janelia-modular-devices/modular_device_base/README.org

#+TITLE: modular_device_base
#+AUTHOR: Peter Polidoro
#+EMAIL: peter@polidoro.io

* Repository Information
  - Author :: Peter Polidoro
  - License :: BSD
