janelia-modular-devices/modular_device_base/(list of files, drawings)

Other design files:
hardware/modular_device_teensy.dsn
pcb/modular_device_teensy.dsn
