janelia-modular-devices/modular_device_base/hardware/modular_device_teensy.kicad_pcb

## KiCad design hardware/modular_device_teensy.kicad_pcb (2016-08-08, last stored version)

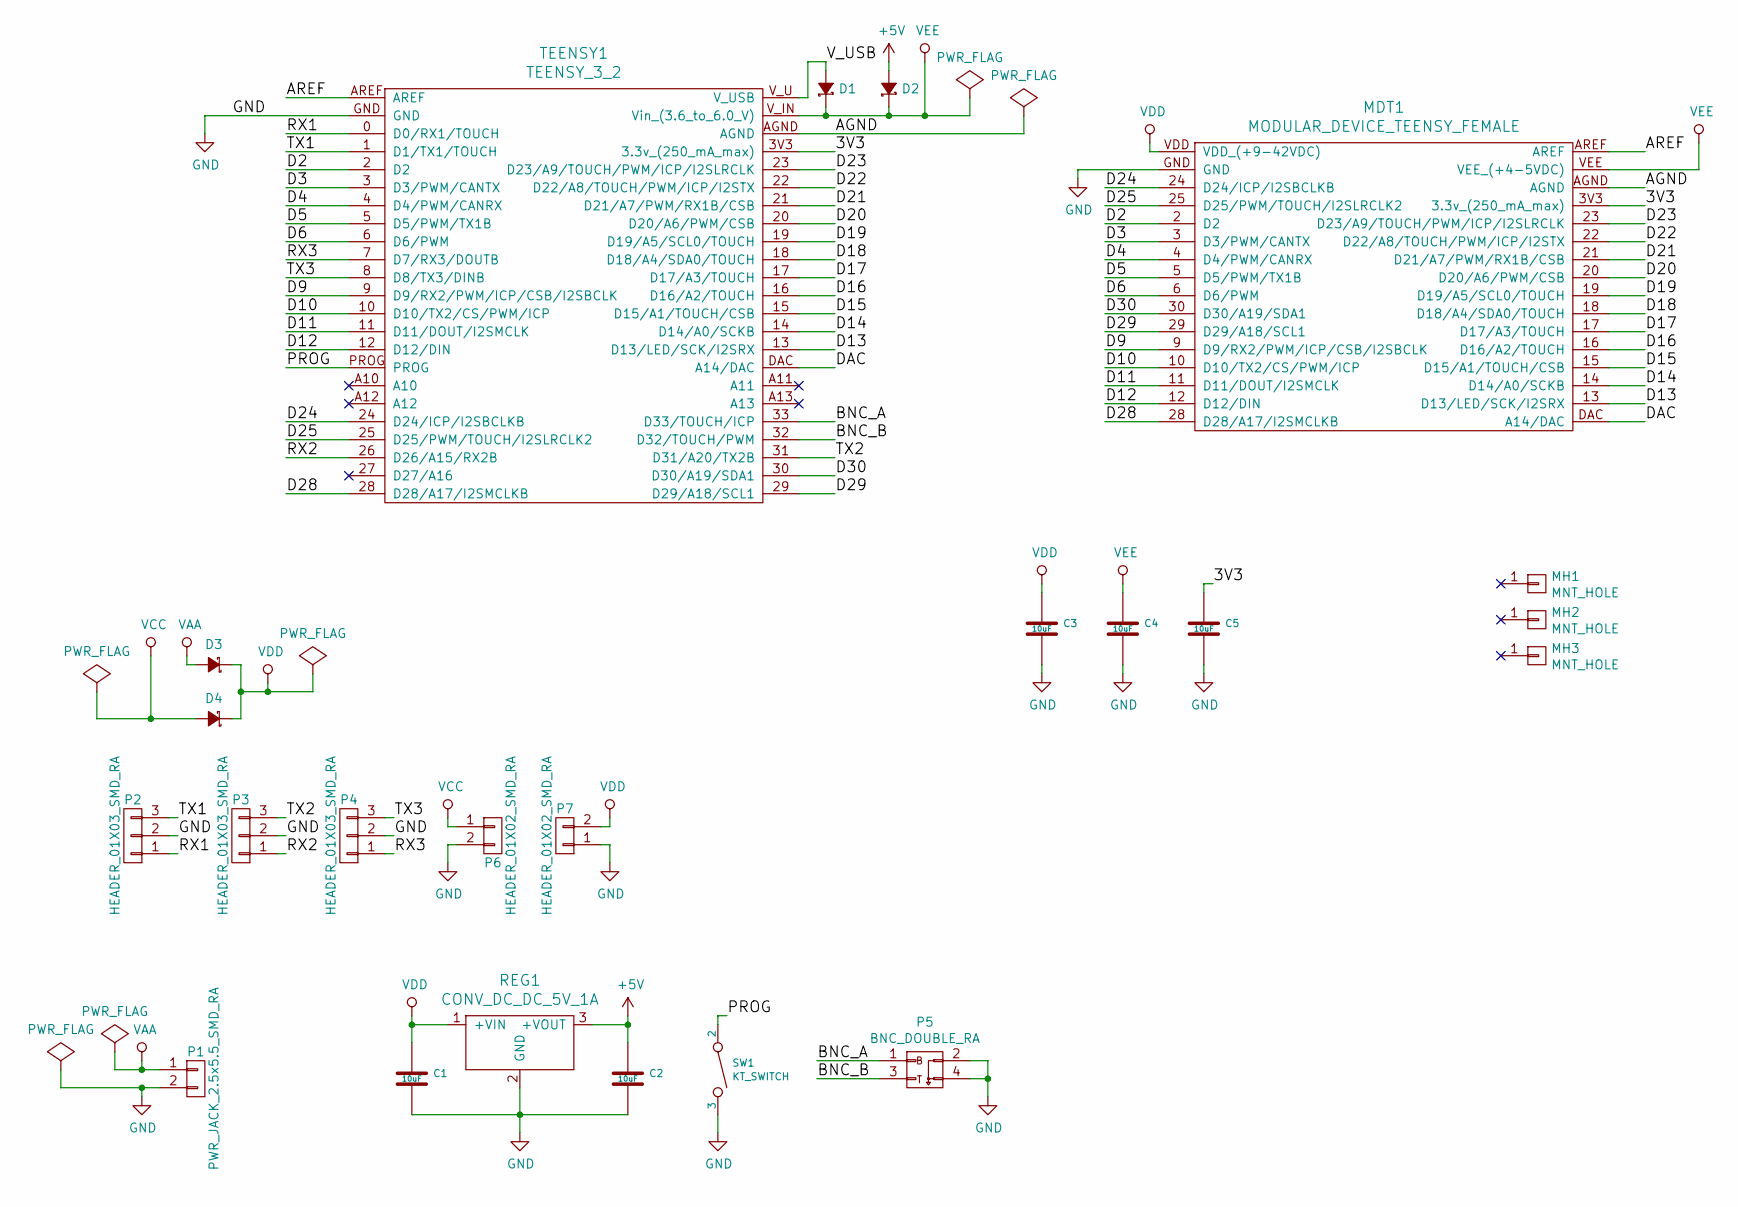
[picture p1: schematic modular_device_teensy.sch]

Parts:
C1, C2, C3, C4, C5: 10uF; SM1210; PartNumber 445-4536-1-ND
D1, D2: diode_schottky_15V_1A; DO-214BA; PartNumber LSM115JE3/TR13CT-ND
D3, D4: diode_schottky_45V_10A; CFP15; PartNumber 568-11697-1-ND
MDT1: MODULAR_DEVICE_TEENSY_FEMALE; PartNumber S7049-ND
MH1, MH2, MH3: MNT_HOLE; MOUNTING_HOLE_4-40; PartNumber 36-2027-ND
P1: PWR_JACK_2.5x5.5_SMD_RA; DCJACK_2PIN_HIGHCURRENT_SMD_RA; PartNumber CP-002BHPJCT-ND
P2, P3, P4: HEADER_01X03_SMD_RA; Header_3_Pin_SMD_RA; PartNumber A100890CT-ND
P5: BNC_DOUBLE_RA; BNC_DOUBLE; PartNumber ACX1655-ND
P6, P7: HEADER_01X02_SMD_RA; Header_2_Pin_SMD_RA; PartNumber A100903CT-ND
REG1: CONV_DC_DC_5V_1A; DC_DC_CONV_R78C; PartNumber 945-1395-5-ND
SW1: KT_SWITCH; PartNumber CKN1860CT-ND
TEENSY1: TEENSY_3_2; TEENSY_3; PartNumber 1568-1231-ND

Connections:
+5V: C2.1, D2.2 (A), REG1.3 (+VOUT)
/3V3: C5.1, MDT1.3V3 (3.3v_(250_mA_max)), TEENSY1.3V3 (3.3v_(250_mA_max))
/AGND: MDT1.AGND, TEENSY1.AGND
/AREF: MDT1.AREF, TEENSY1.AREF
/BNC_A: P5.1, TEENSY1.33 (D33/TOUCH/ICP)
/BNC_B: P5.3, TEENSY1.32 (D32/TOUCH/PWM)
/D2: MDT1.2 (D2), TEENSY1.2 (D2)
/D3: MDT1.3 (D3/PWM/CANTX), TEENSY1.3 (D3/PWM/CANTX)
/D4: MDT1.4 (D4/PWM/CANRX), TEENSY1.4 (D4/PWM/CANRX)
/D5: MDT1.5 (D5/PWM/TX1B), TEENSY1.5 (D5/PWM/TX1B)
/D6: MDT1.6 (D6/PWM), TEENSY1.6 (D6/PWM)
/D9: MDT1.9 (D9/RX2/PWM/ICP/CSB/I2SBCLK), TEENSY1.9 (D9/RX2/PWM/ICP/CSB/I2SBCLK)
/D10: MDT1.10 (D10/TX2/CS/PWM/ICP), TEENSY1.10 (D10/TX2/CS/PWM/ICP)
/D11: MDT1.11 (D11/DOUT/I2SMCLK), TEENSY1.11 (D11/DOUT/I2SMCLK)
/D12: MDT1.12 (D12/DIN), TEENSY1.12 (D12/DIN)
/D13: MDT1.13 (D13/LED/SCK/I2SRX), TEENSY1.13 (D13/LED/SCK/I2SRX)
/D14: MDT1.14 (D14/A0/SCKB), TEENSY1.14 (D14/A0/SCKB)
/D15: MDT1.15 (D15/A1/TOUCH/CSB), TEENSY1.15 (D15/A1/TOUCH/CSB)
/D16: MDT1.16 (D16/A2/TOUCH), TEENSY1.16 (D16/A2/TOUCH)
/D17: MDT1.17 (D17/A3/TOUCH), TEENSY1.17 (D17/A3/TOUCH)
/D18: MDT1.18 (D18/A4/SDA0/TOUCH), TEENSY1.18 (D18/A4/SDA0/TOUCH)
/D19: MDT1.19 (D19/A5/SCL0/TOUCH), TEENSY1.19 (D19/A5/SCL0/TOUCH)
/D20: MDT1.20 (D20/A6/PWM/CSB), TEENSY1.20 (D20/A6/PWM/CSB)
/D21: MDT1.21 (D21/A7/PWM/RX1B/CSB), TEENSY1.21 (D21/A7/PWM/RX1B/CSB)
/D22: MDT1.22 (D22/A8/TOUCH/PWM/ICP/I2STX), TEENSY1.22 (D22/A8/TOUCH/PWM/ICP/I2STX)
/D23: MDT1.23 (D23/A9/TOUCH/PWM/ICP/I2SLRCLK), TEENSY1.23 (D23/A9/TOUCH/PWM/ICP/I2SLRCLK)
/D24: MDT1.24 (D24/ICP/I2SBCLKB), TEENSY1.24 (D24/ICP/I2SBCLKB)
/D25: MDT1.25 (D25/PWM/TOUCH/I2SLRCLK2), TEENSY1.25 (D25/PWM/TOUCH/I2SLRCLK2)
/D28: MDT1.28 (D28/A17/I2SMCLKB), TEENSY1.28 (D28/A17/I2SMCLKB)
/D29: MDT1.29 (D29/A18/SCL1), TEENSY1.29 (D29/A18/SCL1)
/D30: MDT1.30 (D30/A19/SDA1), TEENSY1.30 (D30/A19/SDA1)
/DAC: MDT1.DAC (A14/DAC), TEENSY1.DAC (A14/DAC)
/PROG: SW1.2, TEENSY1.PROG
/RX1: P2.1, TEENSY1.0 (D0/RX1/TOUCH)
/RX2: P3.1, TEENSY1.26 (D26/A15/RX2B)
/RX3: P4.1, TEENSY1.7 (D7/RX3/DOUTB)
/TX1: P2.3, TEENSY1.1 (D1/TX1/TOUCH)
/TX2: P3.3, TEENSY1.31 (D31/A20/TX2B)
/TX3: P4.3, TEENSY1.8 (D8/TX3/DINB)
/V_USB: D1.2 (A), TEENSY1.V_U (V_USB)
GND: C1.2, C2.2, C3.2, C4.2, C5.2, MDT1.GND, P1.2, P2.2, P3.2, P4.2, P5.2, P5.4, P6.2, P7.1, REG1.2 (GND), SW1.3, TEENSY1.GND
VAA: D3.2 (A), P1.1
VCC: D4.2 (A), P6.1
VDD: C1.1, C3.1, D3.1 (K), D4.1 (K), MDT1.VDD (VDD_(+9-42VDC)), P7.2, REG1.1 (+VIN)
VEE: C4.1, D1.1 (K), D2.1 (K), MDT1.VEE (VEE_(+4-5VDC)), TEENSY1.V_IN (Vin_(3.6_to_6.0_V))

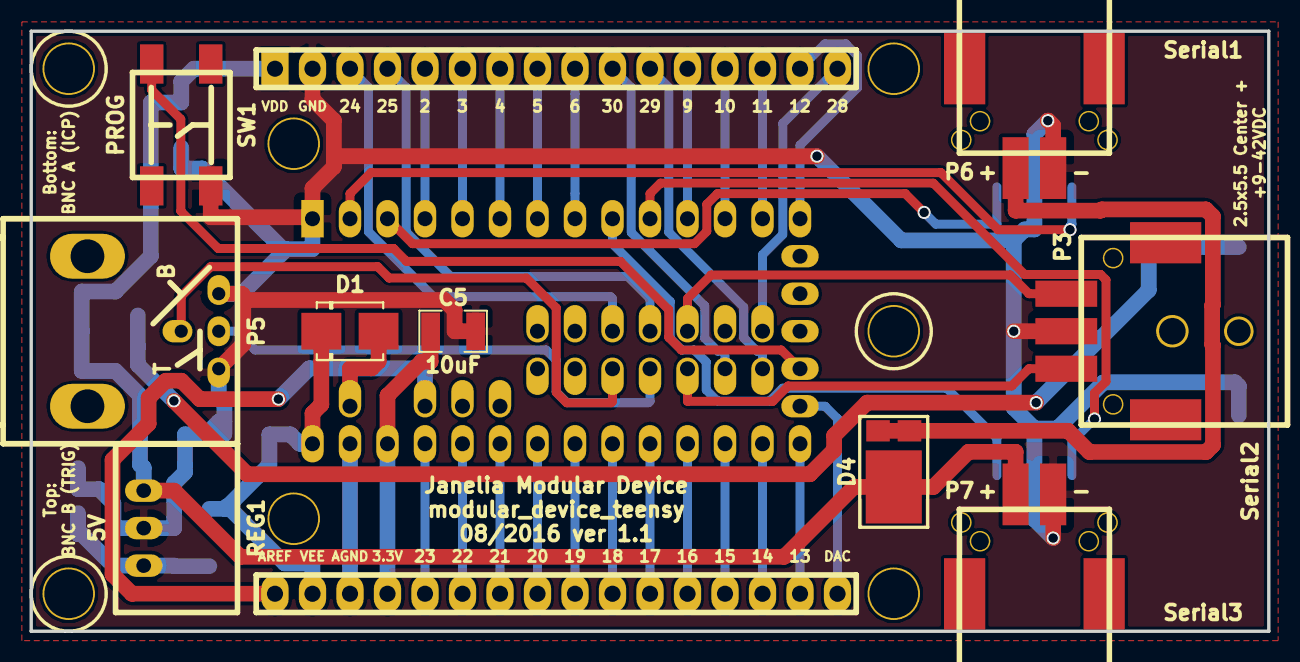
[picture p2: board modular_device_teensy.kicad_pcb from above]

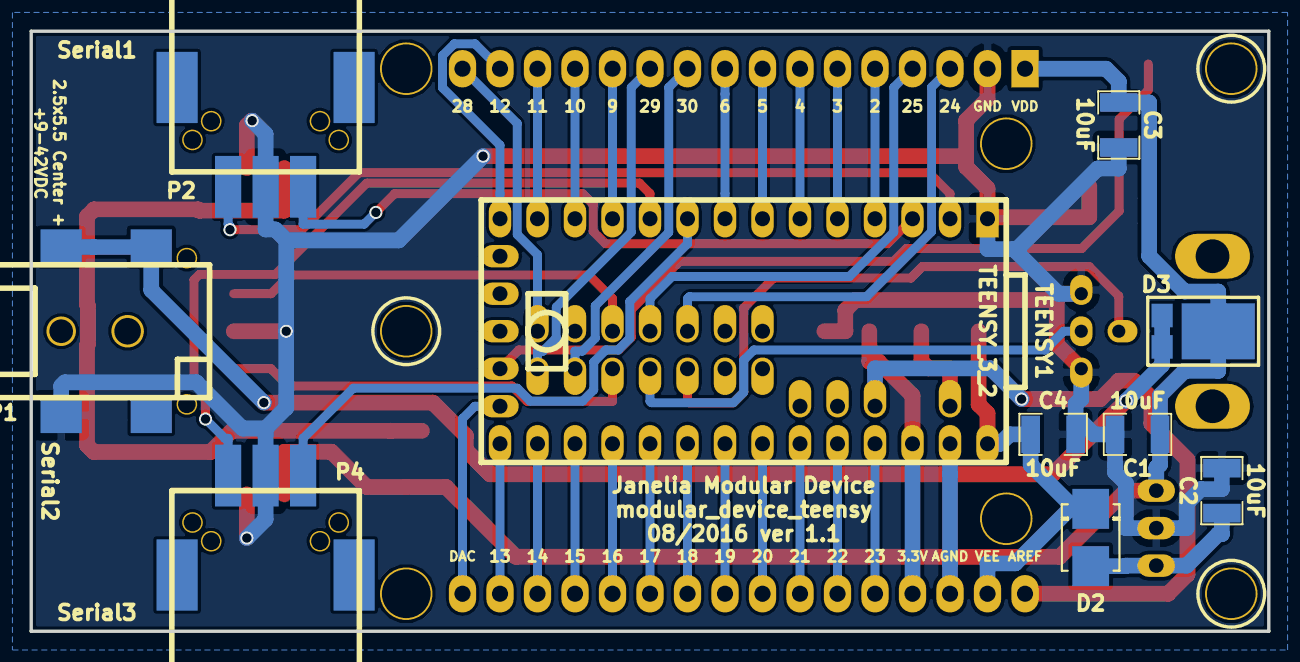
[picture p3: board modular_device_teensy.kicad_pcb from below]

Board: 2 copper layers, 83.8 x 40.6 mm, 23 parts (10 on the bottom side), 45 nets.
