janelia-modular-devices/modular_device_base/(commit log)

2016-06-03 Initial commit.
    [modular_device_teensy.kicad_pcb, modular_device_teensy.sch]
2016-06-03 Progress towards v1.0.
    [modular_device_teensy.kicad_pcb, modular_device_teensy.sch]
2016-06-17 Added some components.
    [modular_device_teensy.kicad_pcb, modular_device_teensy.sch]
2016-06-17 Progress towards board layout.
    [modular_device_teensy.kicad_pcb, modular_device_teensy.sch]
2016-06-24 More progress towards v1.0.
    [modular_device_teensy.kicad_pcb, modular_device_teensy.sch]
2016-06-28 Progess towards new layout.
    [modular_device_teensy.kicad_pcb, modular_device_teensy.sch]
2016-07-14 Small footprint placement changes.
    [modular_device_teensy.kicad_pcb]
2016-07-18 Updated component.
    [bom_pcb_add.csv, digikey_order.csv, modular_device_teensy.sch]
2016-07-18 Finished pcb v1.0.
    [bom_pcb.csv, bom_pcb_add.csv, digikey_order.csv, digikey_order_pcb.csv, digikey_order_pcb_add.csv, modular_device_teensy.sch]
2016-07-19 Updated footprint after testing.
2016-07-20 Progress towards v1.1.
    [bom_pcb_add.csv, digikey_order.csv, digikey_order_pcb_add.csv, modular_device_teensy.sch]
2016-07-20 Updated schematic pdf.
2016-07-21 Updated footprint to proper orientation.
2016-07-22 Increased length of footprint.
2016-07-22 More progress towards pcb v1.1.
    [modular_device_teensy.kicad_pcb, modular_device_teensy.sch]
2016-07-25 Modified mounting hole spacer diameter.
    [modular_device_teensy.kicad_pcb, modular_device_teensy.sch]
2016-07-27 Switch to new MODULAR_DEVICE_TEENSY footprint.
    [modular_device_teensy.kicad_pcb, modular_device_teensy.sch]
2016-08-01 Added pin names and numbers to footprint.
    [modular_device_teensy.kicad_pcb]
2016-08-08 Finished pcb v1.1.
    [bom_pcb.csv, digikey_order.csv, digikey_order_pcb.csv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]
2016-09-21 pcb -> hardware.
    [bom_pcb.csv, bom_pcb_add.csv, digikey_order.csv, digikey_order_pcb.csv, digikey_order_pcb_add.csv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]
2017-02-02 Removed hardware files.
    [bom_pcb.csv, bom_pcb_add.csv, digikey_order.csv, digikey_order_pcb.csv, digikey_order_pcb_add.csv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]
